harwoodr/6GA3/sched/README.TXT

The sched executable is intended for a raspberry pi with xenomai and wiringPi installed.
