harwoodr/6GA3/documents/platforms_schem.pdf

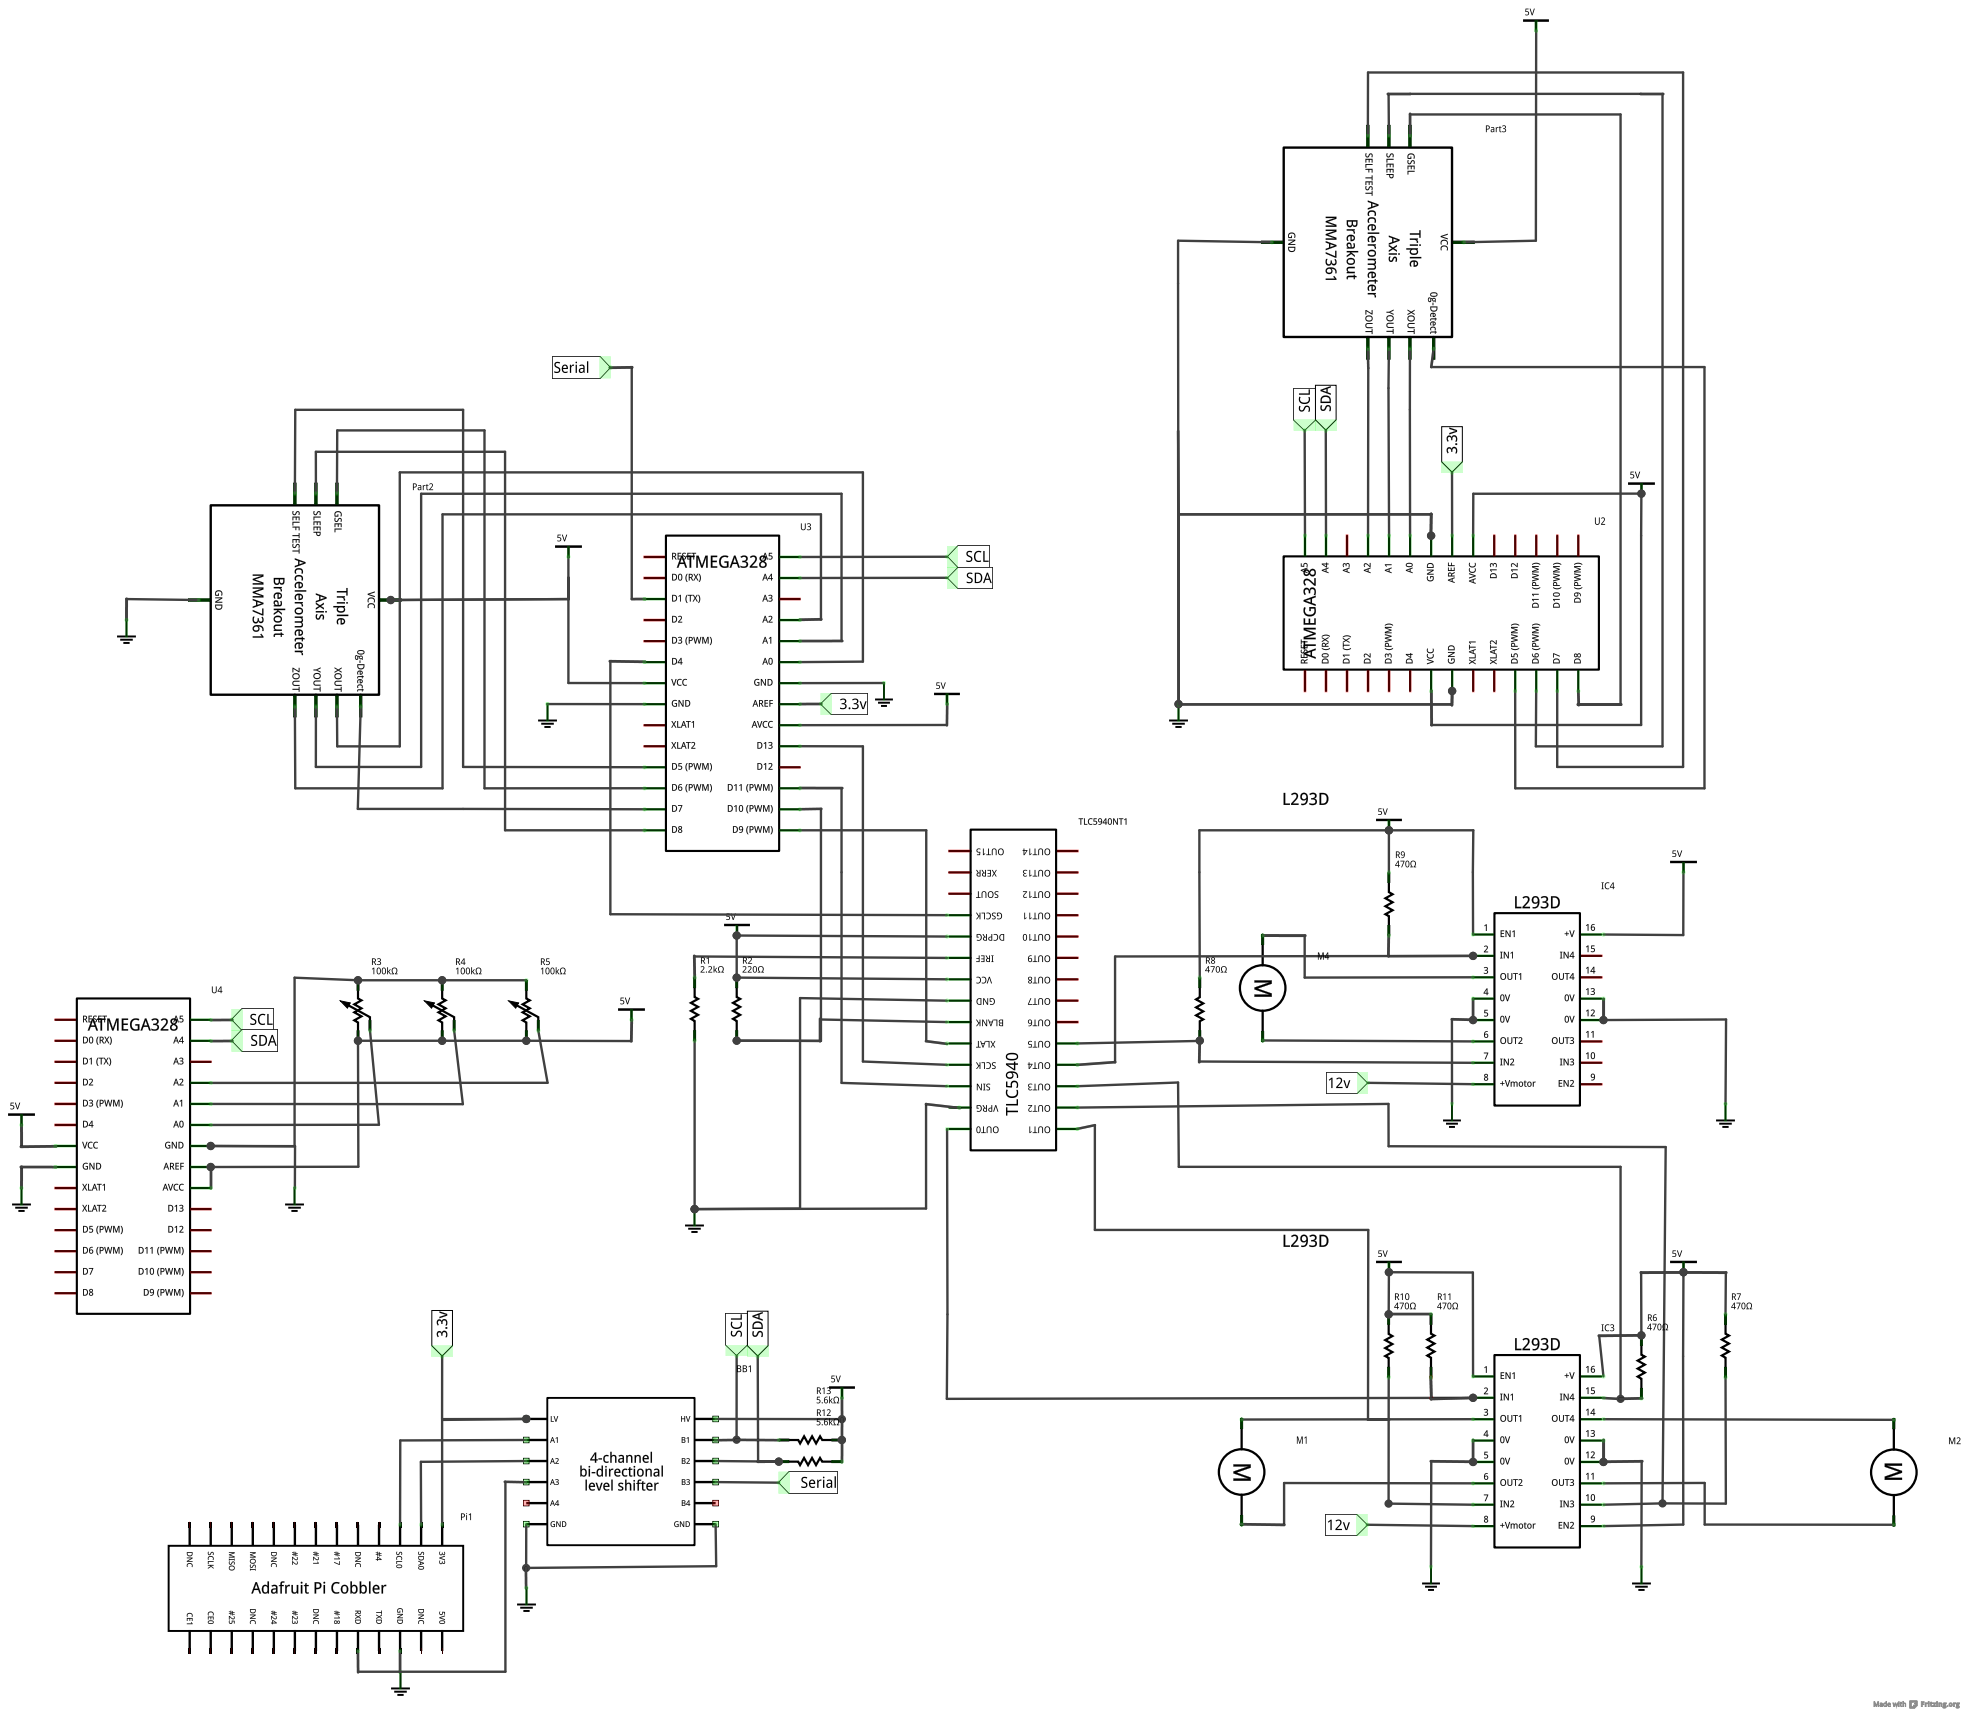
[picture p1: page 1]
