harwoodr/6GA3/documents/DFD.pdf

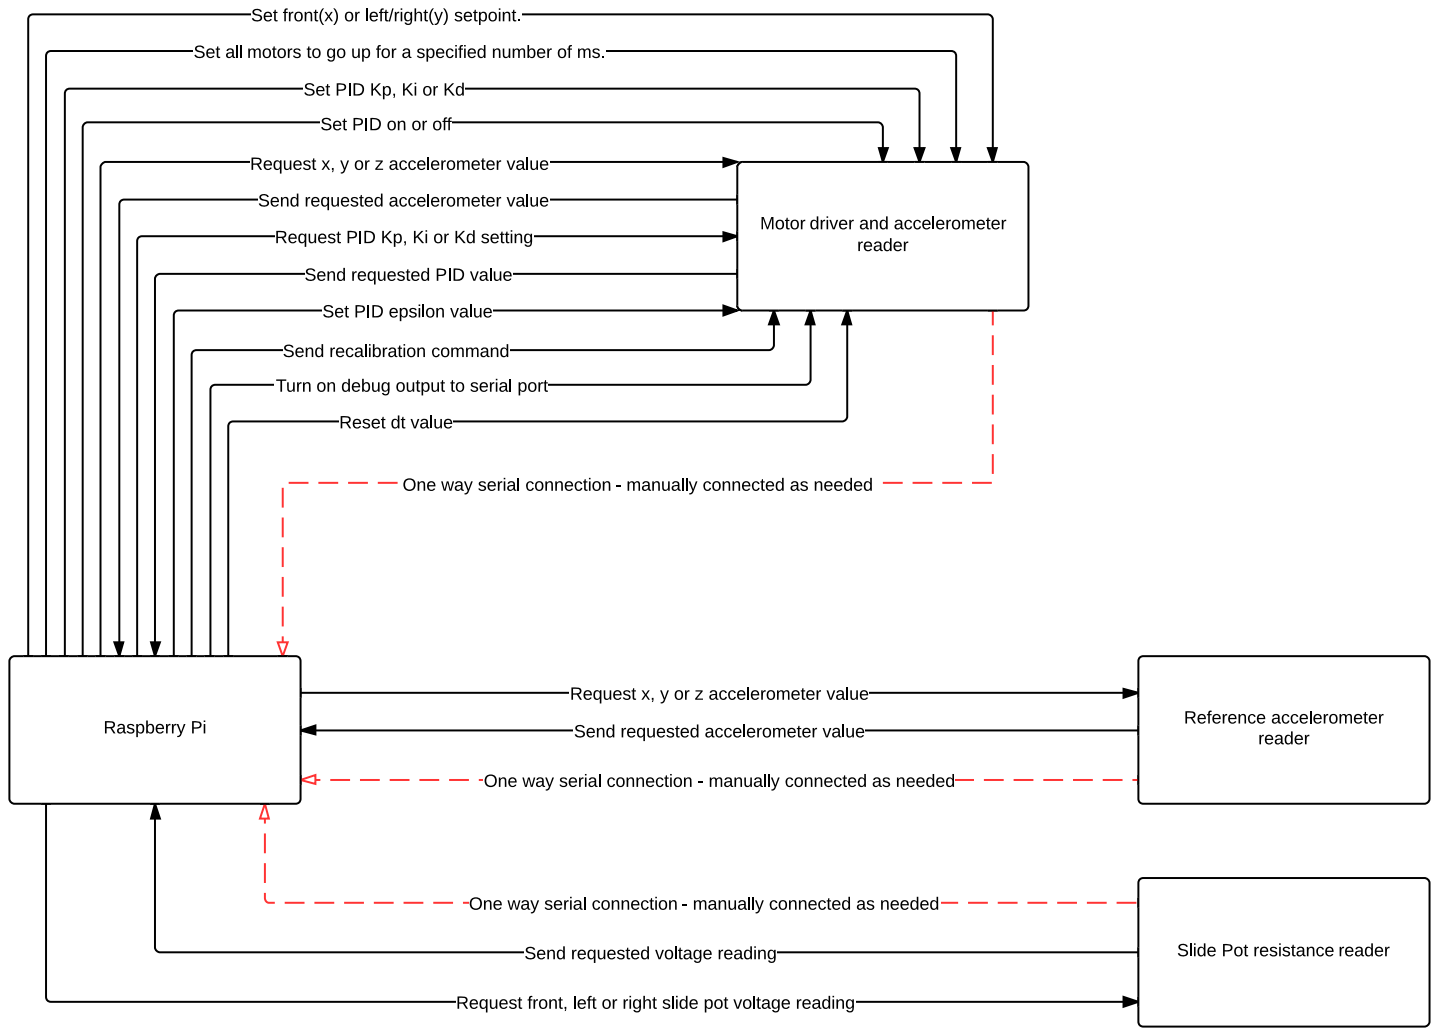
[picture p2: page 1]
