harwoodr/6GA3/(commit log)

2014-01-07 Added Data Flow Diagram
2014-01-10 schematics added
2014-01-10 Updated to reflect schematic added
